arffimrxn/secure-coldchain-monitor-iot-security/security/README.md

# Security

- `threat-model.md` — STRIDE + MTSFB risk register + attack tree
- `incident-playbook.md` — detect → contain → recover, incl. device revocation
- RTM (requirements traceability) lives as the project spreadsheet; link the latest export here.
