arffimrxn/secure-coldchain-monitor-iot-security/docs/04-mqtt-baseline.md

# Stage 4 — MQTT baseline (insecure, measured)

## What I did

## 📸 Evidence to capture
- [ ] wiring photo
- [ ] working screenshot (serial / dashboard / capture)
- [ ] (security stages) BEFORE vs AFTER proof

## Problems & fixes

## Result
