arffimrxn/secure-coldchain-monitor-iot-security/docs/05-gateway-mobius.md

# Stage 5 — Gateway (Mosquitto + bridge) + Mobius oneM2M

## What I did

## 📸 Evidence to capture
- [ ] wiring photo
- [ ] working screenshot (serial / dashboard / capture)
- [ ] (security stages) BEFORE vs AFTER proof

## Problems & fixes

## Result
