arffimrxn/secure-coldchain-monitor-iot-security/docs/06-security-hardening.md

# Stage 6 — Security hardening (mTLS, ACL, oneM2M ACP, firewall)

## What I did

## 📸 Evidence to capture
- [ ] wiring photo
- [ ] working screenshot (serial / dashboard / capture)
- [ ] (security stages) BEFORE vs AFTER proof

## Problems & fixes

## Result
