arffimrxn/secure-coldchain-monitor-iot-security/docs/07-threat-model.md

# Stage 7 — Threat model, monitoring & incident response

## What I did

## 📸 Evidence to capture
- [ ] wiring photo
- [ ] working screenshot (serial / dashboard / capture)
- [ ] (security stages) BEFORE vs AFTER proof

## Problems & fixes

## Result
