arffimrxn/secure-coldchain-monitor-iot-security/security/incident-playbook.md

# Incident response playbook

## Detect
- Dashboard alert rules (≥3, across ≥2 layers), <60 s to detect

## Triage
## Contain
- Device revocation: revoke Node 2 cert → rejected at broker; Node 1 unaffected (rehearsed)

## Recover
## Lessons learned
