arffimrxn/secure-coldchain-monitor-iot-security/security/threat-model.md

# Threat model — STRIDE + MTSFB

> Grows in Stage 7. Keep it evidence-backed: each threat maps to a control in the RTM.

## Data-flow diagram
- (link evidence/ DFD)

## STRIDE table
| # | Element | Threat (STRIDE) | MTSFB (T-Sec/T-Saf/T-P) | Control (M#) | Status |
|---|---|---|---|---|---|

## Attack tree
- Goal: forge/suppress a fridge alert

## Risk register (≥12 threats)
