arffimrxn/secure-coldchain-monitor-iot-security/docs/evidence/stage_0/00-architecture.png

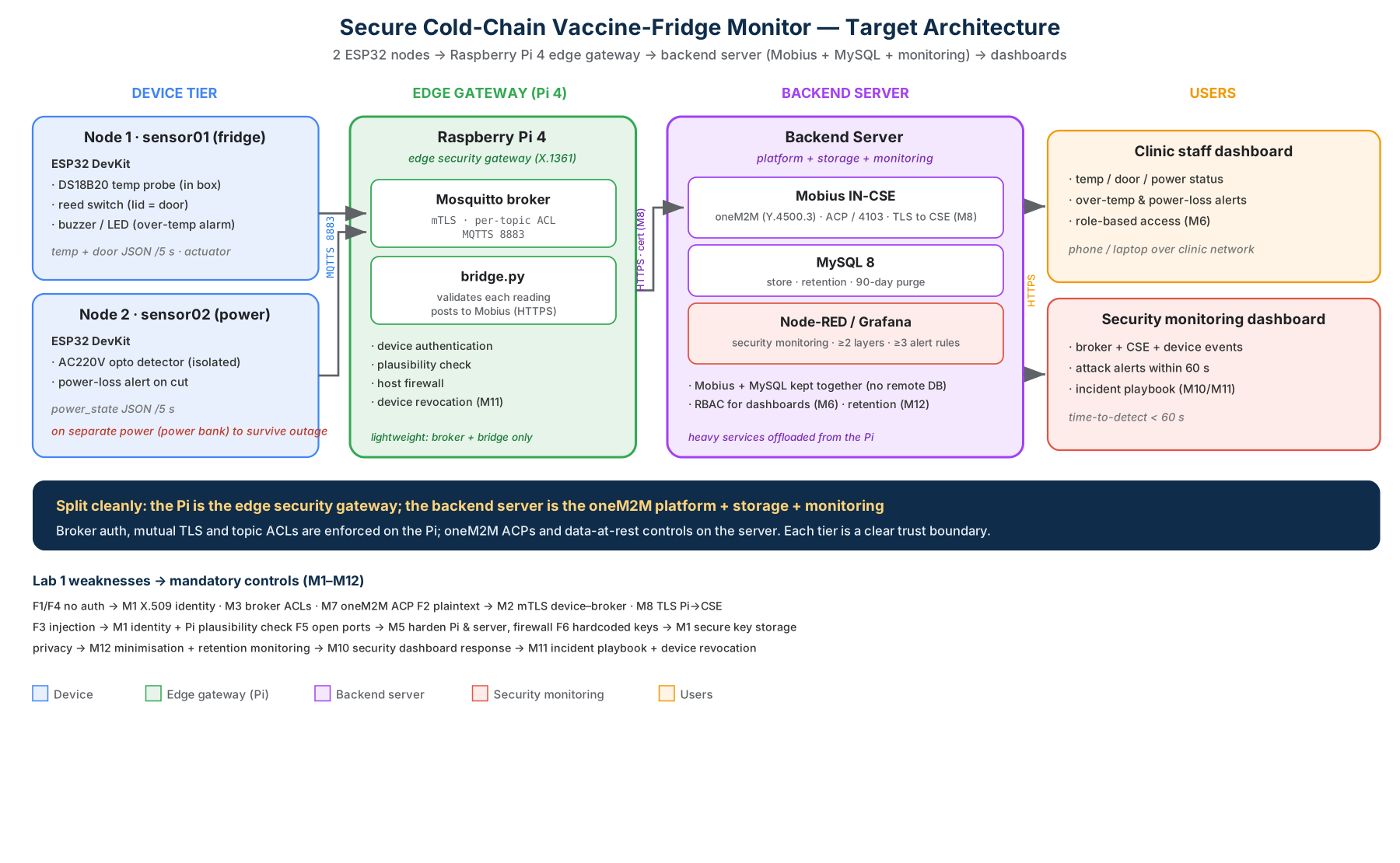
docs/evidence/stage_0/00-architecture.png
