arffimrxn/secure-coldchain-monitor-iot-security/docs/evidence/stage_0/esp32_node1_blink.jpg

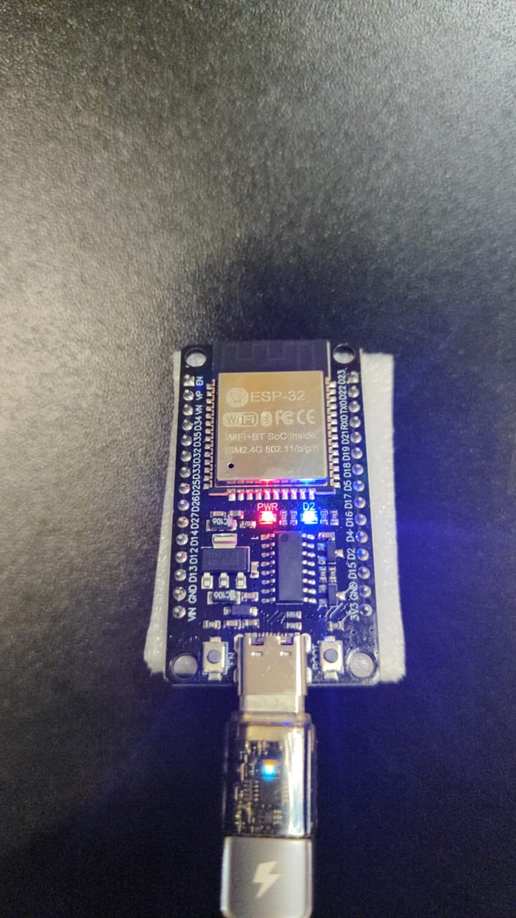
docs/evidence/stage_0/esp32_node1_blink.jpg
