arffimrxn/secure-coldchain-monitor-iot-security/(commit log)

2026-11-05 Stage 0-1: toolchain verified, security LED on GPIO23
2026-11-05 Add new evidence images for LED setup
    Updated evidence section with additional image references.
2026-11-13 Stages 2-5: Node 1 sensors and alarms, Node 2 power-loss detection
2026-11-13 Fix image links (file-name case), rename satge_2 to stage_2
2026-11-13 Reorder test cases for reed switch documentation
2026-11-13 Update expected peak temperature in buzzer alarms doc
2026-11-13 Clarify expected result for door open alarm test
    Updated expected result for door open test case to specify timing.
